brianredbeard/MakerPass/WiegandBoard/schematics/README.md

#MakerPass Wiegand Board
See the wiki page for features and more.

###Tasks
See the schematic for pending task list
