brianredbeard/MakerPass/WiegandBoard/schematics/bom/weigand-bom.xlsx

Part | Qty | Value | Device | Supplier | Price | Extended
C4 | 1 | 220uF 35V polarized | Kemet A700X227M004ATE010 | Newark | $1.75 | $1.75
C5-C6 | 2 | 22pF | AVX 06035A220JAT2A | Newark | $0.02 | $0.04
C1,C7 | 1 | 100nF | AVX 0603YC104KAT2A | Newark | $0.01 | $0.01
D1 | 1 | SMA Diode | Bourns CD214A-B120LF | Mouser | $0.44 | $0.44
F1 | 1 | PTCSMD | TE Connectivity NANOSMDC150F-2 | Newark | $0.34 | $0.34
J1 | 1 | Programming Header (M2x3) |  |  |  | $0.00
JP1,JP6-JP19 |  | Screw Terminal - 3.5mm x 2 | OSTTE020104 | Digi-Key | $0.36 | $0.00 | 0.41 | 0
 |  | Screw Terminal - 3.5mm x 12 | OSTTE120104 | Digi-Key | $1.57 | $0.00
JP2-JP5 | 4 | Jumper (M02PTH) |  |  |  | $0.00
JP21 | 1 | Jumper (M03PTH) |  |  |  | $0.00
LED1-LED17 | 17 | LED1206 | Avago HSMH-C170 | Newark | $0.07 | $1.14
R1 | 1 | 4k7 0603-RES | Panasonic - ECG ERJ-3GEYJ472V | Newark | $0.00 | $0.00
R14, R16, R18 | 3 | 1K 0603-RES | Panasonic - ECG ERJ-3EKF1001V | Newark | $0.00 | $0.01
R15 | 1 | 100 0603-RES | Panasonic - ECG ERJ-3EKF1001V | Newark | $0.00 | $0.00
R2-R13,R19-R22 | 16 | 440 ohm resistor | Panasonic - ECG ERJ3EKF3300V | Newark | $0.00 | $0.03
S2 | 1 | RESET | C&K Components PTS525SM10SMTRLFS | Newark | $0.91 | $0.91
U1 | 1 | ATMEGA168 | Atmel ATMEGA168-20AU | Mouser | $3.03 | $3.03
U2 | 1 | RS485_SP491 | Exar SP491EEN-L | Newark | $1.65 | $1.65 | ?
U3 | 1 | MIC5219 5V | NCP1117ST50T3G | Newark | $1.91 | $1.91
U4-U9 | 6 | MOC3063 | Fairchild Semiconductor MOC3063M | Newark | $0.84 | $5.04 | 0.74 | 4.44
X1-X2 | 2 | RJ45-8PTH | Areva 54602-908LF | Newark | $0.55 | $1.09
Y1 | 1 | 16Mhz | Fox Electronics FOXSDLF/160-20 | Digi-Key | $0.63 | $0.63
 |  |  |  |  |  | $18.02
