brianredbeard/MakerPass/WiegandBoard/schematics/export/Wiegand_OUTLINE.dxf

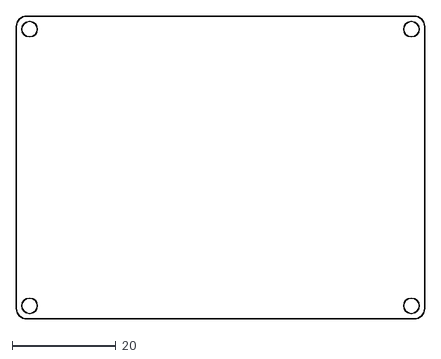
[picture p1: CAD file, 2014-02-13]
WiegandBoard/schematics/export/Wiegand_OUTLINE.dxf
78.7 x 58.4
