brianredbeard/MakerPass/WiegandBoard/schematics/render/eagleUp/MakerPass_Wiegand_board_revB_ISO.png

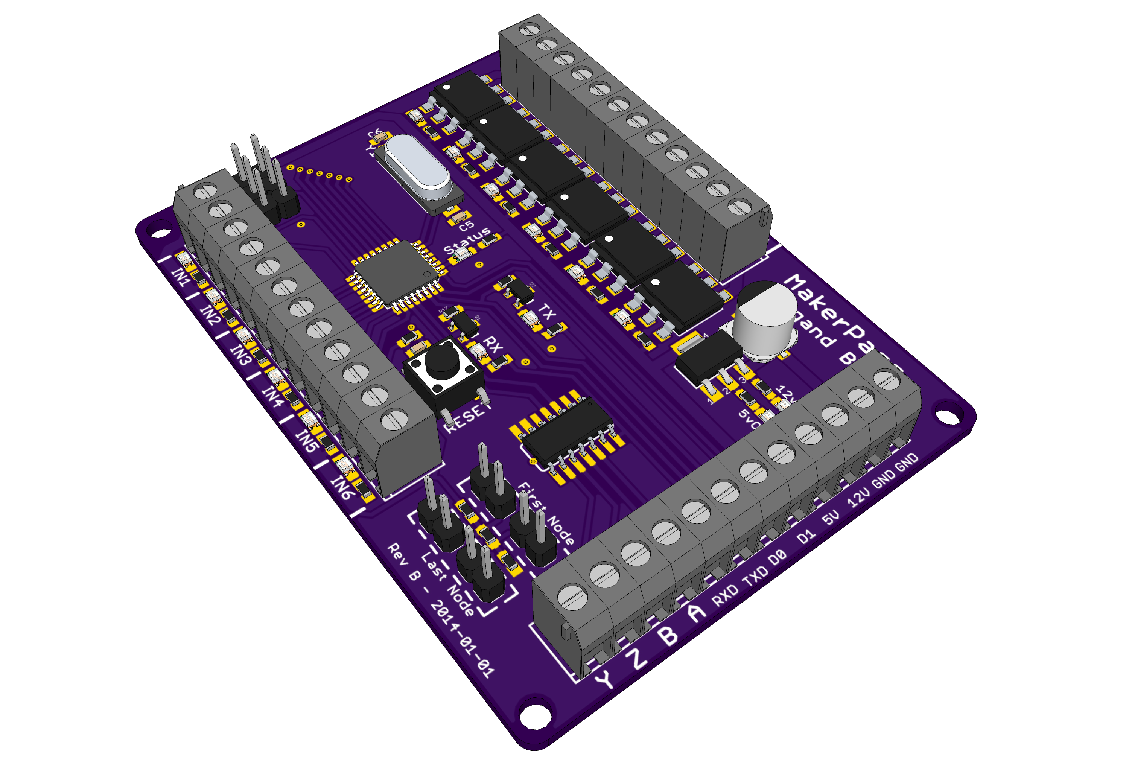
WiegandBoard/schematics/render/eagleUp/MakerPass_Wiegand_board_revB_ISO.png
