brianredbeard/MakerPass/WiegandBoard/schematics/render/eagleUp/MakerPass_Wiegand_board_revB_TOP.png

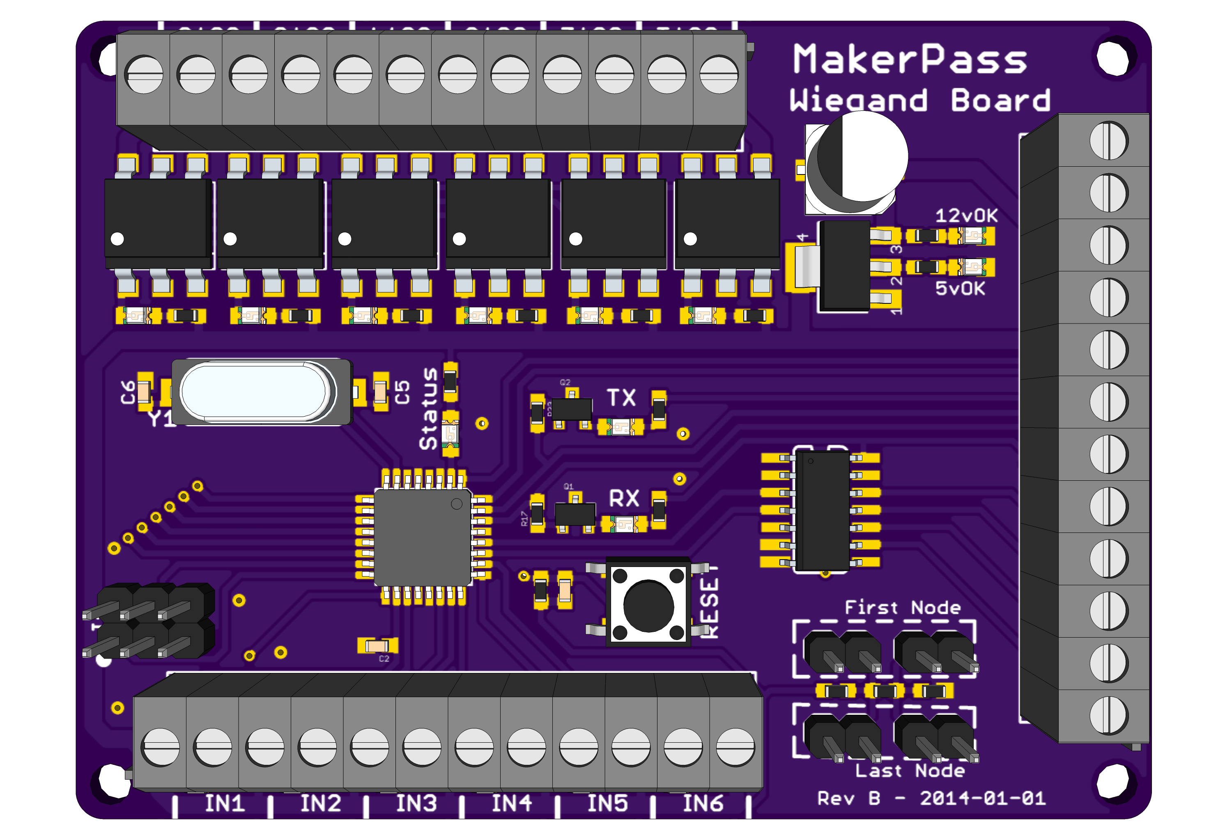
WiegandBoard/schematics/render/eagleUp/MakerPass_Wiegand_board_revB_TOP.png
