brianredbeard/MakerPass/WiegandBoard/schematics/render/eagleUp/MakerPass_Wiegand_board_revC_ISO.png

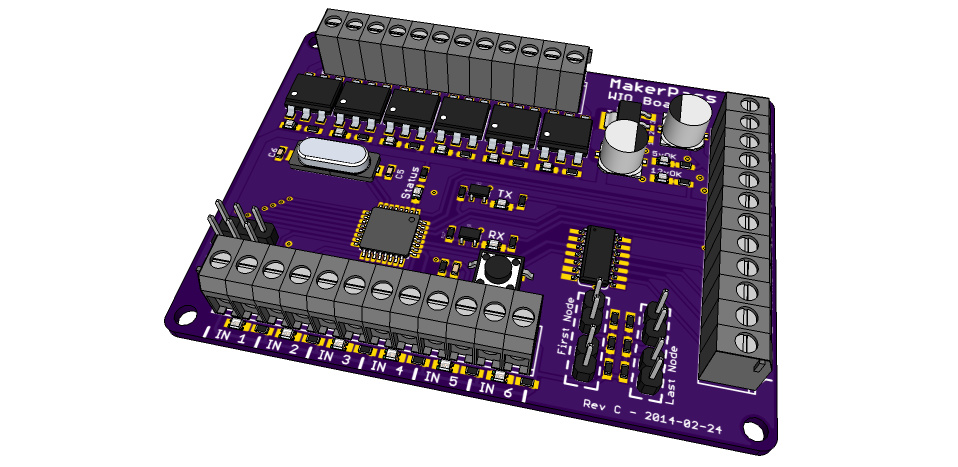
WiegandBoard/schematics/render/eagleUp/MakerPass_Wiegand_board_revC_ISO.png
