brianredbeard/MakerPass/WiegandBoard/schematics/Wiegand.brd

## EAGLE design WiegandBoard/schematics/Wiegand.brd (2014-04-03)

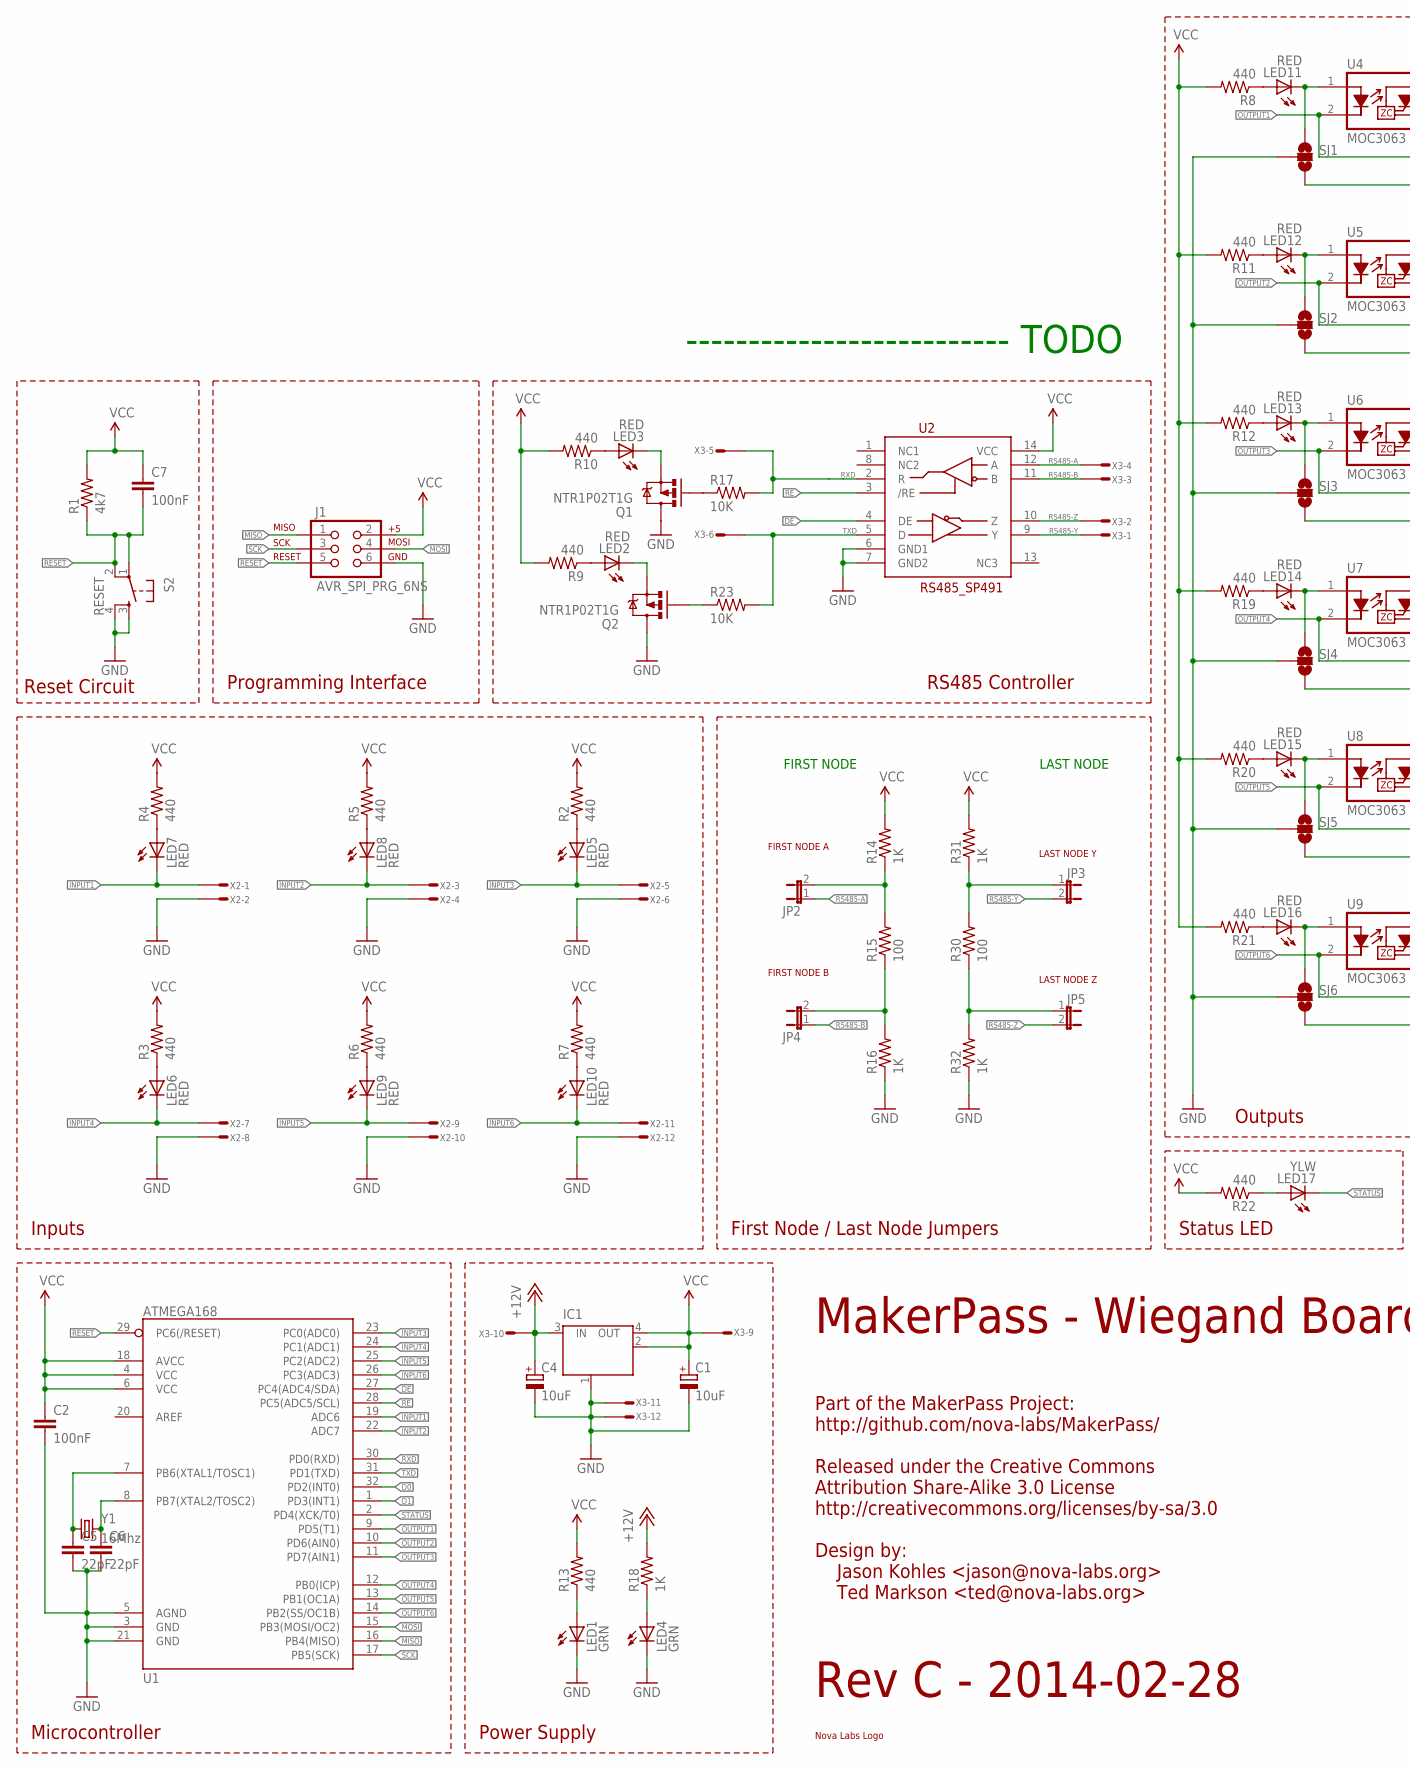
[picture p6: schematic Wiegand.sch, part in row 1, column 1]

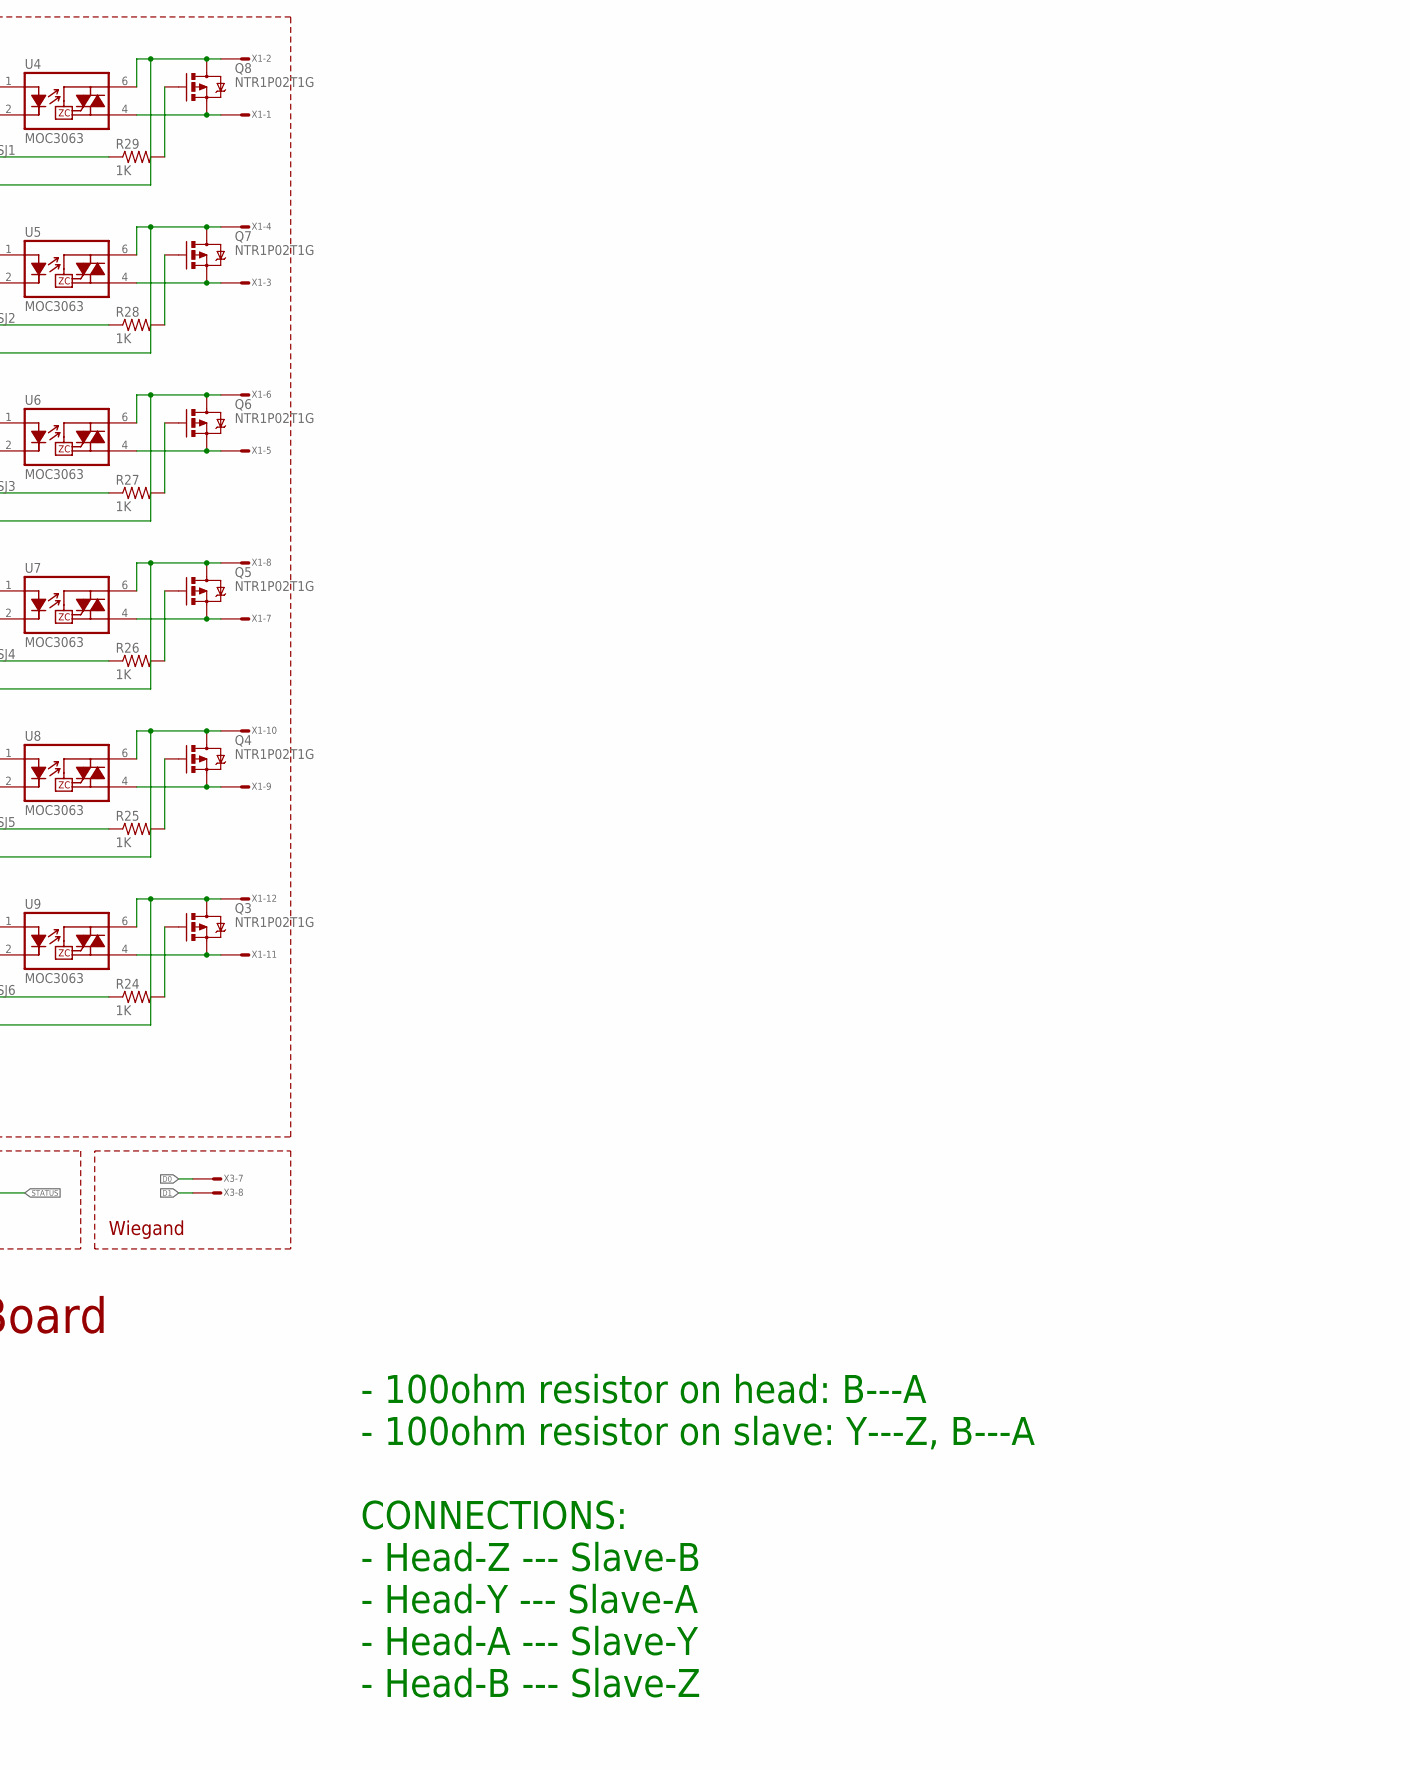
[picture p7: schematic Wiegand.sch, part in row 1, column 2]

Parts:
C1, C4: 10uF; PANASONIC_D; MFG_PN EMVA250ADA100MD55G
C2, C7: 100nF; 0603-CAP; MFG_PN 0603YC104KAT2A
C5, C6: 22pF; 0603-CAP; MFG_PN 06035A220JAT2A
IC1: MC33269ST-3.3T3; SOT223; MFG_PN NCP1117ST50T3G
J1: AVR_SPI_PRG_6NS; 2X3-NS
JP2, JP3, JP4, JP5: JUMPER-2PTH; 1X02; MFG_PN 1x2 pin header
LED1, LED4: GRN; LED-805; MFG_PN LG R971-KN-1
LED2, LED3, LED5, LED6, LED7, LED8, LED9, LED10, LED11, LED12, LED13, LED14, LED15, LED16: RED; LED-805; MFG_PN LH R974-LP-1
LED17: YLW; LED-805; MFG_PN LY R976-PS-36
Q1, Q2, Q3, Q4, Q5, Q6, Q7, Q8: NTR1P02T1G; SOT23-3; MFG_PN NTR1P02T1G
R1: 4k7; 0603-RES; MFG_PN ERJ-3GEYJ472V
R2, R3, R4, R5, R6, R7, R8, R9, R10, R11, R12, R13, R19, R20, R21, R22: 440; 0603-RES; MFG_PN ERJ3EKF3300V
R14, R16, R18, R24, R25, R26, R27, R28, R29, R31, R32: 1K; 0603-RES; MFG_PN ERJ-3EKF1001V
R15, R30: 100; 0603-RES; MFG_PN ERJ-3EKF1001V
R17, R23: 10K; 0603-RES; MFG_PN ERJ3EKF3300V
S2: RESET; TACTILE_SWITCH_SMD; MFG_PN PTS525SM10SMTRLFS
SJ1, SJ2, SJ3, SJ4, SJ5, SJ6: SOLDERJUMPER_2WAY-TRACE1&2&3; SJ_3_WIRE1&2&3
U1: ATMEGA168; TQFP32-08; MFG_PN ATMEGA168-20AU
U2: RS485_SP491; SOIC-14; MFG_PN SP491EEN-L
U4, U5, U6, U7, U8, U9: MOC3063; DIP8SMD; MFG_PN MOC3063S-TA1
X1, X2, X3: CON-1X12-TERMBLOCK-3.5MM; MFG_PN OSTTE120104
X4: NOVA-LABS-LOGO-SILK-400MIL
Y1: 16Mhz; HC49UP; MFG_PN FOXSDLF/160-20

Connections:
+12V: C4.+, IC1.3 (IN), R18.2, X3.10
D0: U1.32 (PD2(INT0)), X3.7
D1: U1.1 (PD3(INT1)), X3.8
DE: U1.27 (PC4(ADC4/SDA)), U2.4 (DE)
GND: C1.-, C2.2, C4.-, C5.2, C6.2, IC1.1 (GND/ADJ), J1.6, LED1.C, LED4.C, Q1.3 (D), Q2.3 (D), R16.1, R32.1, S2.3, S2.4, SJ1.2, SJ2.2, SJ3.2, SJ4.2, SJ5.2, SJ6.2, U1.3 (GND), U1.5 (AGND), U1.21 (GND), U2.6 (GND1), U2.7 (GND2), X2.2, X2.4, X2.6, X2.8, X2.10, X2.12, X3.11, X3.12
INPUT1: LED7.C, U1.19 (ADC6), X2.1
INPUT2: LED8.C, U1.22 (ADC7), X2.3
INPUT3: LED5.C, U1.23 (PC0(ADC0)), X2.5
INPUT4: LED6.C, U1.24 (PC1(ADC1)), X2.7
INPUT5: LED9.C, U1.25 (PC2(ADC2)), X2.9
INPUT6: LED10.C, U1.26 (PC3(ADC3)), X2.11
MISO: J1.1, U1.16 (PB4(MISO))
MOSI: J1.4, U1.15 (PB3(MOSI/OC2))
unnamed: LED1.A, R13.1
unnamed: Q4.2 (S), U8.4 (T2), X1.9
unnamed: Q4.3 (D), SJ5.3, U8.6 (T1), X1.10
unnamed: LED5.A, R2.1
unnamed: JP5.1, R30.1, R32.2
unnamed: JP3.1, R30.2, R31.1
unnamed: LED4.A, R18.1
unnamed: LED3.C, Q1.2 (S)
unnamed: LED6.A, R3.1
unnamed: LED7.A, R4.1
unnamed: LED8.A, R5.1
unnamed: LED9.A, R6.1
unnamed: LED10.A, R7.1
unnamed: LED11.C, SJ1.1, U4.1 (A)
unnamed: LED11.A, R8.1
unnamed: Q8.3 (D), SJ1.3, U4.6 (T1), X1.2
unnamed: Q7.2 (S), U5.4 (T2), X1.3
unnamed: Q7.3 (D), SJ2.3, U5.6 (T1), X1.4
unnamed: LED12.A, R11.1
unnamed: LED12.C, SJ2.1, U5.1 (A)
unnamed: Q6.2 (S), U6.4 (T2), X1.5
unnamed: Q6.3 (D), SJ3.3, U6.6 (T1), X1.6
unnamed: LED13.A, R12.1
unnamed: LED2.A, R9.1
unnamed: LED3.A, R10.1
unnamed: LED13.C, SJ3.1, U6.1 (A)
unnamed: Q5.2 (S), U7.4 (T2), X1.7
unnamed: Q5.3 (D), SJ4.3, U7.6 (T1), X1.8
unnamed: LED14.A, R19.1
unnamed: LED14.C, SJ4.1, U7.1 (A)
unnamed: LED2.C, Q2.2 (S)
unnamed: Q1.1 (G), R17.1
unnamed: LED15.A, R20.1
unnamed: LED15.C, SJ5.1, U8.1 (A)
unnamed: Q3.3 (D), SJ6.3, U9.6 (T1), X1.12
unnamed: Q3.2 (S), U9.4 (T2), X1.11
unnamed: LED16.A, R21.1
unnamed: LED16.C, SJ6.1, U9.1 (A)
unnamed: LED17.A, R22.1
unnamed: Q2.1 (G), R23.1
unnamed: Q4.1 (G), R25.2
unnamed: Q5.1 (G), R26.2
unnamed: Q6.1 (G), R27.2
unnamed: Q7.1 (G), R28.2
unnamed: Q8.1 (G), R29.2
unnamed: JP2.2, R14.1, R15.2
unnamed: JP4.2, R15.1, R16.2
unnamed: Q8.2 (S), U4.4 (T2), X1.1
unnamed: C5.1, U1.7 (PB6(XTAL1/TOSC1)), Y1.1
unnamed: C6.1, U1.8 (PB7(XTAL2/TOSC2)), Y1.2
unnamed: Q3.1 (G), R24.2
OUTPUT1: R29.1, U1.9 (PD5(T1)), U4.2 (K)
OUTPUT2: R28.1, U1.10 (PD6(AIN0)), U5.2 (K)
OUTPUT3: R27.1, U1.11 (PD7(AIN1)), U6.2 (K)
OUTPUT4: R26.1, U1.12 (PB0(ICP)), U7.2 (K)
OUTPUT5: R25.1, U1.13 (PB1(OC1A)), U8.2 (K)
OUTPUT6: R24.1, U1.14 (PB2(SS/OC1B)), U9.2 (K)
RE: U1.28 (PC5(ADC5/SCL)), U2.3 (/RE)
RESET: C7.2, J1.5, R1.1, S2.1, S2.2, U1.29 (PC6(/RESET))
RS485-A: JP2.1, U2.12 (A), X3.4
RS485-B: JP4.1, U2.11 (B), X3.3
RS485-Y: JP3.2, U2.9 (Y), X3.1
RS485-Z: JP5.2, U2.10 (Z), X3.2
RXD: R17.2, U1.30 (PD0(RXD)), U2.2 (R), X3.5
SCK: J1.3, U1.17 (PB5(SCK))
STATUS: LED17.C, U1.2 (PD4(XCK/T0))
TXD: R23.2, U1.31 (PD1(TXD)), U2.5 (D), X3.6
VCC: C1.+, C2.1, C7.1, IC1.2 (OUT), IC1.4 (OUT), J1.2, R1.2, R2.2, R3.2, R4.2, R5.2, R6.2, R7.2, R8.2, R9.2, R10.2, R11.2, R12.2, R13.2, R14.2, R19.2, R20.2, R21.2, R22.2, R31.2, U1.4 (VCC), U1.6 (VCC), U1.18 (AVCC), U2.14 (VCC), X3.9

Notes on the sheet:
RS485 Controller
Programming Interface
Power Supply
Reset Circuit
Wiegand
Part of the MakerPass Project: http://github.com/nova-labs/MakerPass/ Released under the Creative Commons Attribution Share-Alike 3.0 License http://creativecommons.org/licenses/by-sa/3.0 Design by: Jason Kohles <jason@nova-labs.org> Ted Markson <ted@nova-labs.org>
Status LED
First Node / Last Node Jumpers
Outputs
Inputs
Microcontroller
MakerPass - Wiegand Board
Rev C - 2014-02-28
FIRST NODE
LAST NODE
-------------------------- TODO
- 100ohm resistor on head: B---A - 100ohm resistor on slave: Y---Z, B---A CONNECTIONS: - Head-Z --- Slave-B - Head-Y --- Slave-A - Head-A --- Slave-Y - Head-B --- Slave-Z
FIRST NODE A
FIRST NODE B
LAST NODE Z
LAST NODE Y

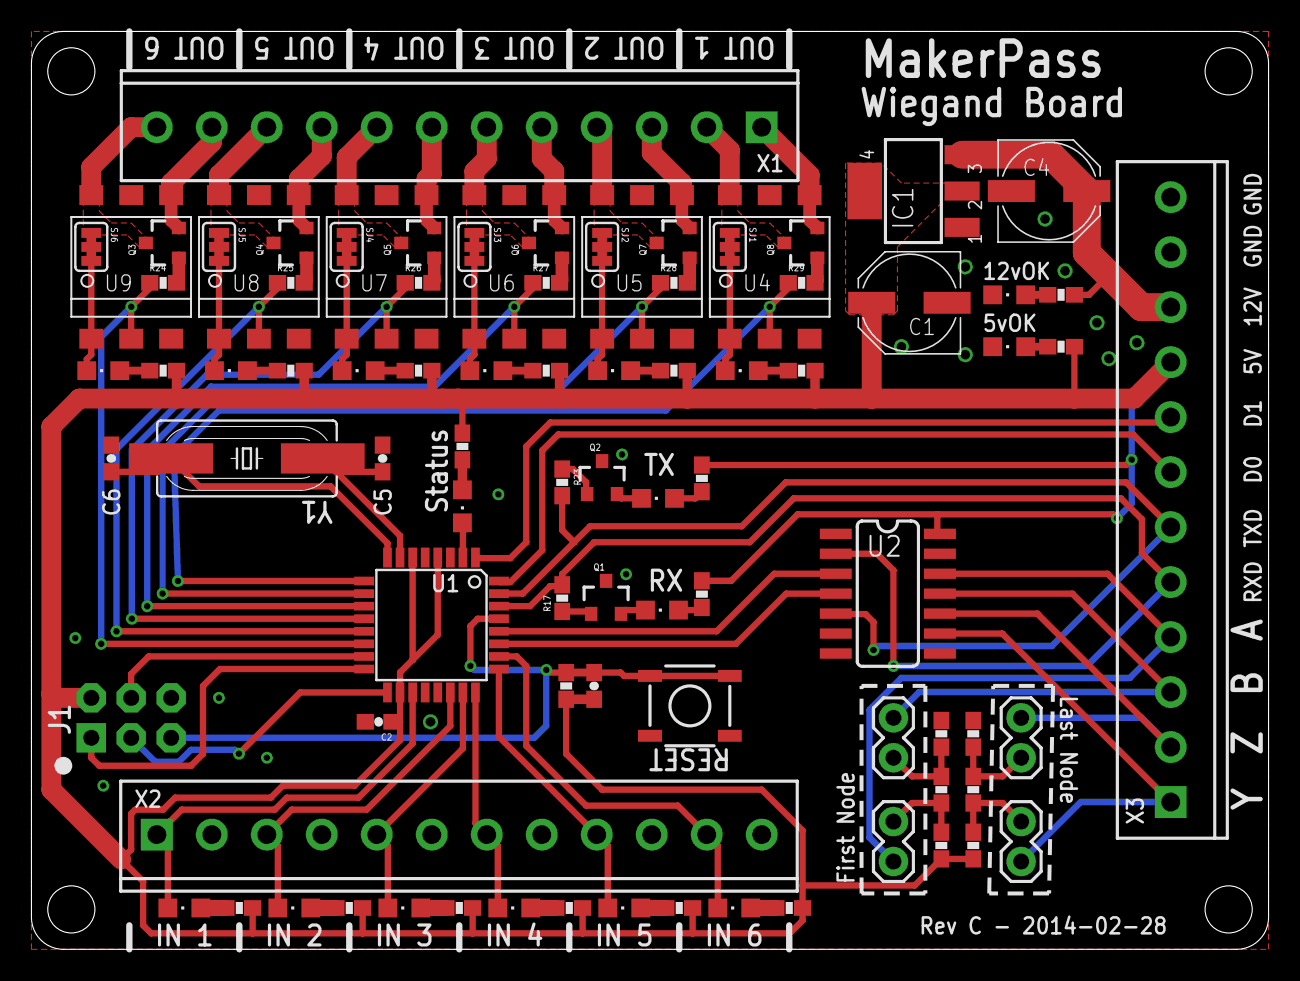
[picture p8: board Wiegand.brd from above]

Board: 2 copper layers, 78.7 x 58.4 mm, 89 parts (1 on the bottom side), 81 nets.
