brianredbeard/MakerPass/(commit log)

2014-02-13 minor changes to board, adding firmware and eagleup render
    [MakerPass_Wiegand_board.skp, Wiegand.brd, Wiegand.sch, Wiegand_OUTLINE.dxf, arduino_Uno_Rev3-02-TH.xls, weigand-bom.xlsx]
2014-02-13 added dimensions and changed rev number in brd file, new eagleup render
    [MakerPass_Wiegand_board.skp]
2014-02-20 added separate resistors for first / last node, added transistor option atop optoisolators
    [Wiegand.brd, Wiegand.sch]
2014-02-22 minor edits to brd, rerendered eagleup model
    [Wiegand.brd, Wiegand.sch]
2014-02-23 minor edits to brd
    [Wiegand.brd, Wiegand.sch]
2014-02-28 put files in wiegandboard project folder
    [Wiegand.brd, Wiegand.sch, Wiegand_OUTLINE.dxf, arduino_Uno_Rev3-02-TH.xls, weigand-bom.xlsx]
2014-04-03 REVC boards made
    [Wiegand.brd, Wiegand.sch]
